devanneil/AutomaticAppleHarvesterCOBOT/QR.png

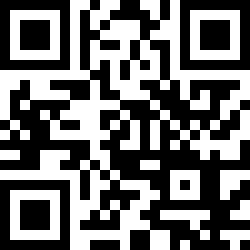
QR.png
