devanneil/AutomaticAppleHarvesterCOBOT/ws/src/robot_model/meshes/bin_assembly.stl

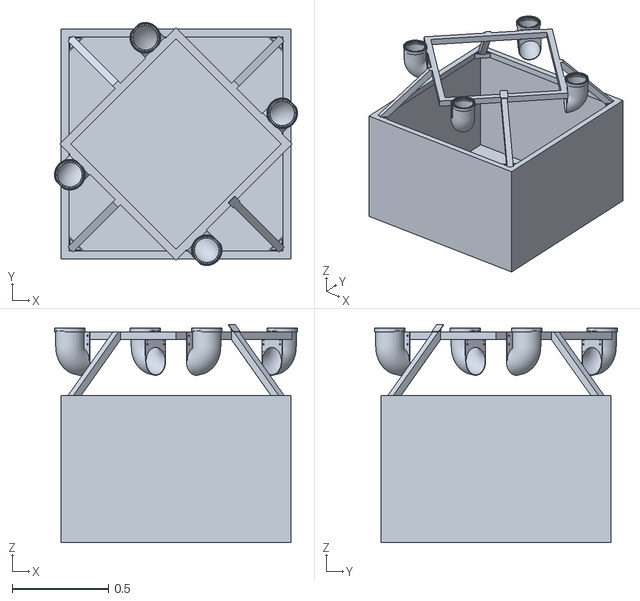
[picture p10: CAD file, 2026-06-25]
ws/src/robot_model/meshes/bin_assembly.stl
1.26 x 1.26 x 1.13
