devanneil/AutomaticAppleHarvesterCOBOT/ws/src/robot_model/meshes/bin_filler/Bottom_Frame_2.stl

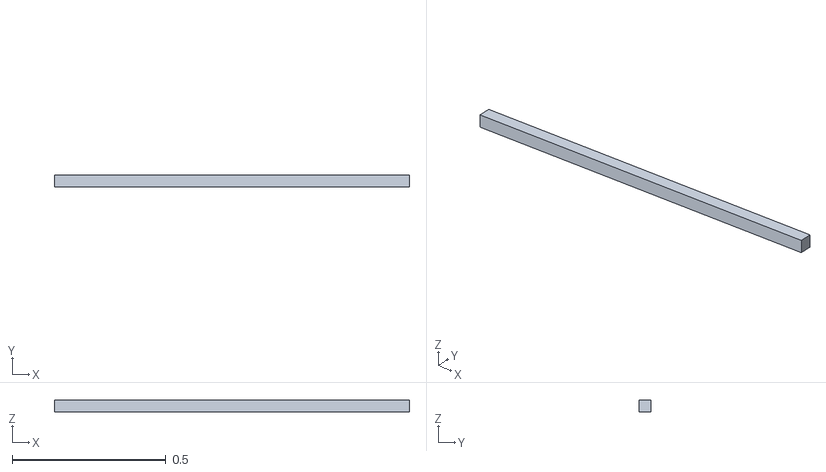
[picture p11: CAD file, 2026-06-24]
ws/src/robot_model/meshes/bin_filler/Bottom_Frame_2.stl
1.15 x 0.04 x 0.04
