devanneil/AutomaticAppleHarvesterCOBOT/ws/src/robot_model/meshes/bin_filler/Corner_8020_Series_15_Bracket_4222026_1.stl

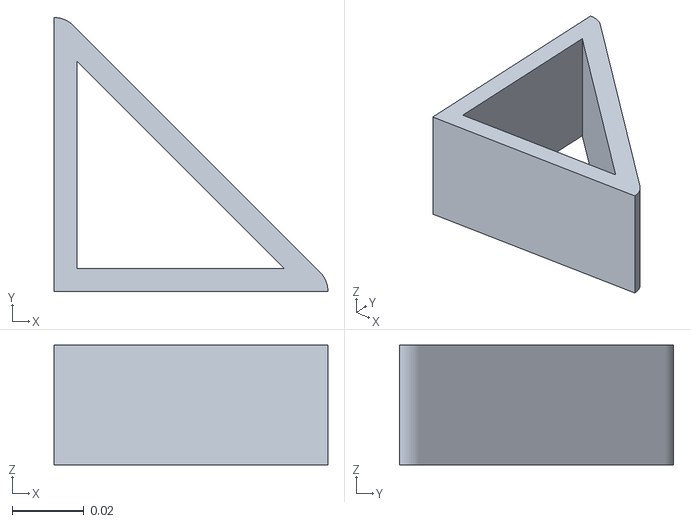
[picture p12: CAD file, 2026-06-24]
ws/src/robot_model/meshes/bin_filler/Corner_8020_Series_15_Bracket_4222026_1.stl
0.0762 x 0.0762 x 0.0333
