devanneil/AutomaticAppleHarvesterCOBOT/ws/src/robot_model/meshes/End_Effector_Bracket_4.2.2026.stl

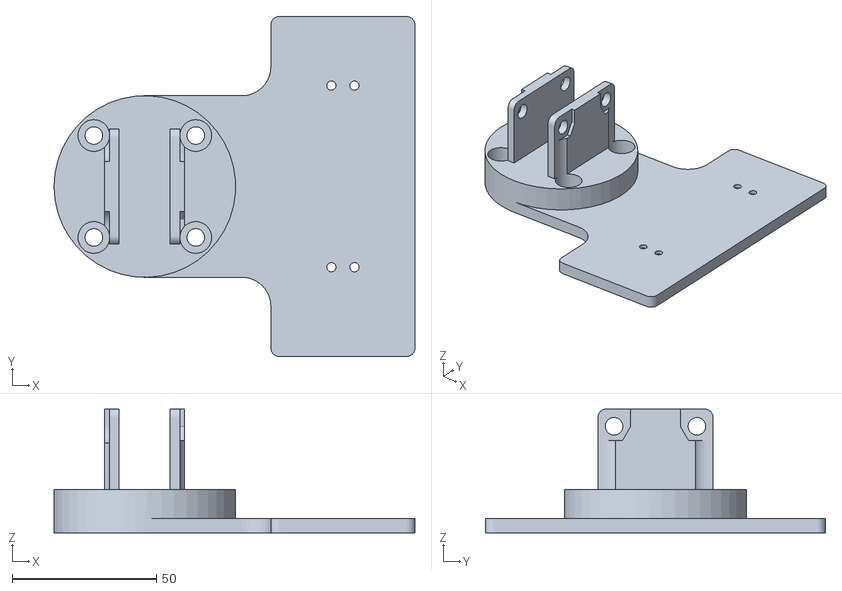
[picture p13: CAD file, 2026-05-20]
ws/src/robot_model/meshes/End_Effector_Bracket_4.2.2026.stl
125.2 x 118.0 x 43.0
