devanneil/AutomaticAppleHarvesterCOBOT/ws/src/robot_model/meshes/bin_filler/Angle_Bracket_1.stl

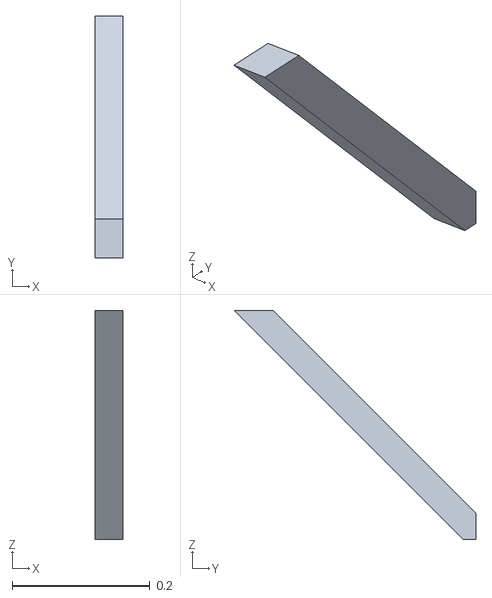
[picture p14: CAD file, 2026-06-24]
ws/src/robot_model/meshes/bin_filler/Angle_Bracket_1.stl
0.04 x 0.351 x 0.332
