devanneil/AutomaticAppleHarvesterCOBOT/ws/src/robot_model/meshes/DS87-Mechanical_Outline_3D.STP.stl

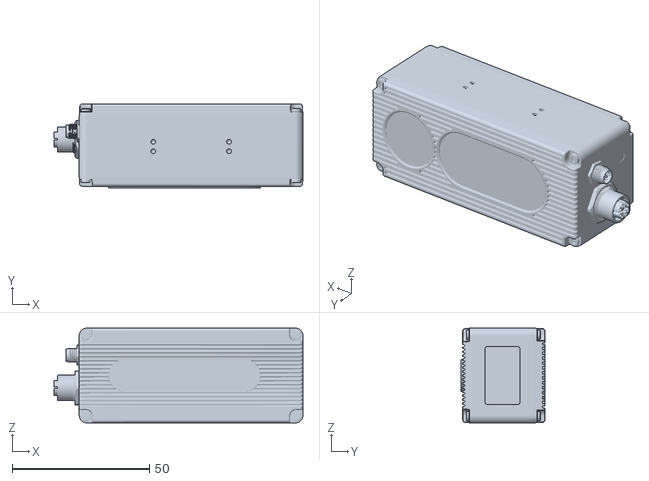
[picture p15: CAD file, 2026-04-21]
ws/src/robot_model/meshes/DS87-Mechanical_Outline_3D.STP.stl
90.8 x 30.8 x 34.6
