devanneil/AutomaticAppleHarvesterCOBOT/ws/src/robot_model/meshes/bin_filler/Apple_Chute_Entrance_4242026_1.stl

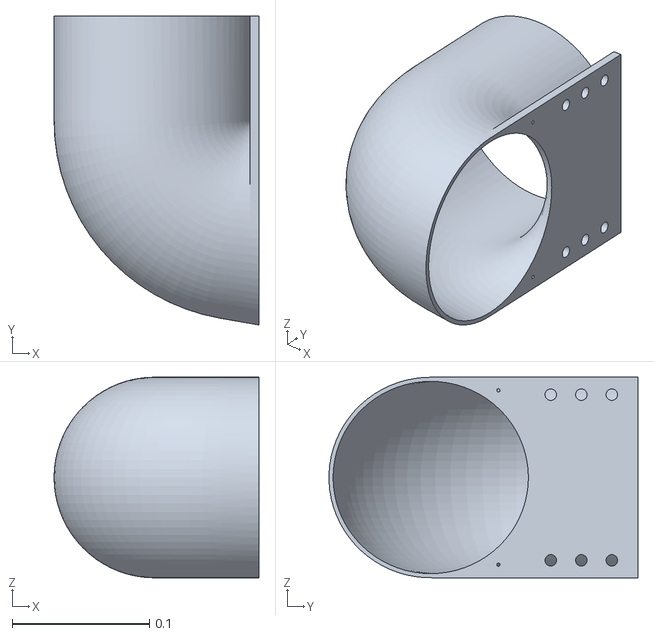
[picture p16: CAD file, 2026-06-24]
ws/src/robot_model/meshes/bin_filler/Apple_Chute_Entrance_4242026_1.stl
0.149 x 0.225 x 0.146
