devanneil/AutomaticAppleHarvesterCOBOT/ws/src/robot_model/meshes/bin_filler/Top_Frame_4.stl

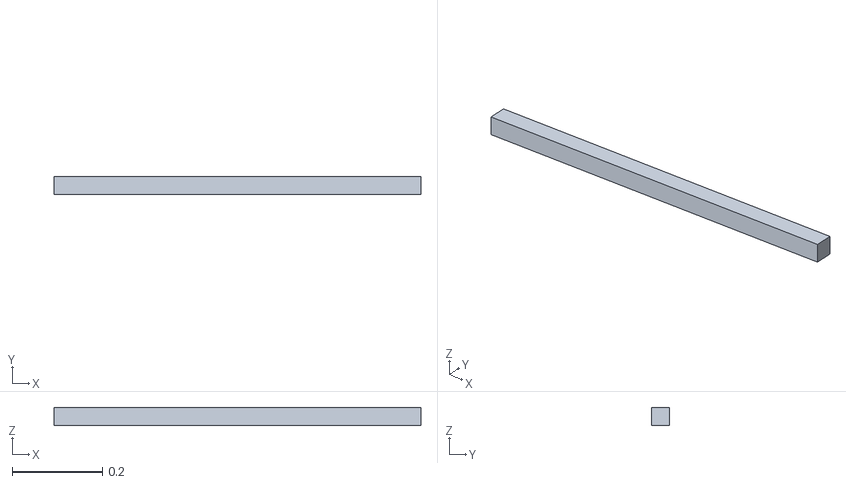
[picture p17: CAD file, 2026-06-24]
ws/src/robot_model/meshes/bin_filler/Top_Frame_4.stl
0.813 x 0.04 x 0.04
