devanneil/AutomaticAppleHarvesterCOBOT/ws/src/robot_model/meshes/bin_filler/Apple_Bin_4222026_1.stl

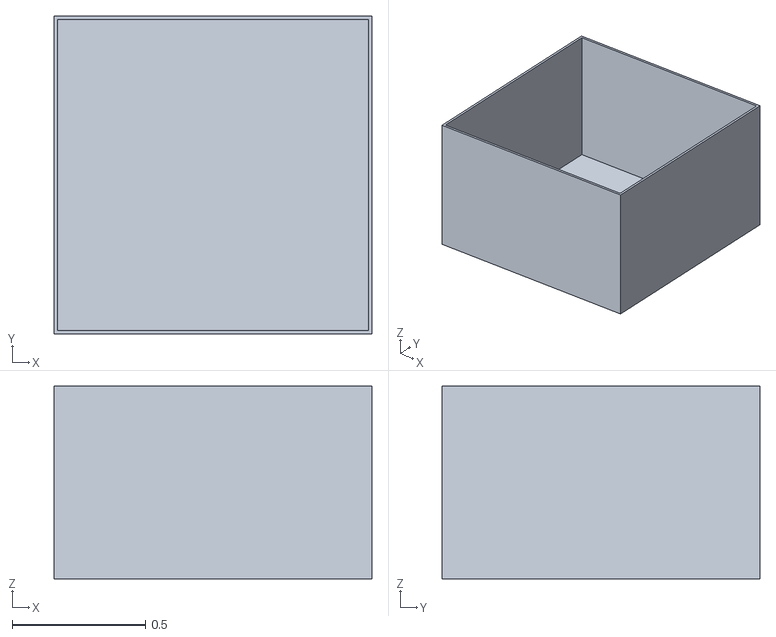
[picture p18: CAD file, 2026-06-24]
ws/src/robot_model/meshes/bin_filler/Apple_Bin_4222026_1.stl
1.19 x 1.19 x 0.724
