devanneil/AutomaticAppleHarvesterCOBOT/ws/src/robot_model/meshes/bin_filler/Rubber_Chute_Entrance_Bumper_54206_3.stl

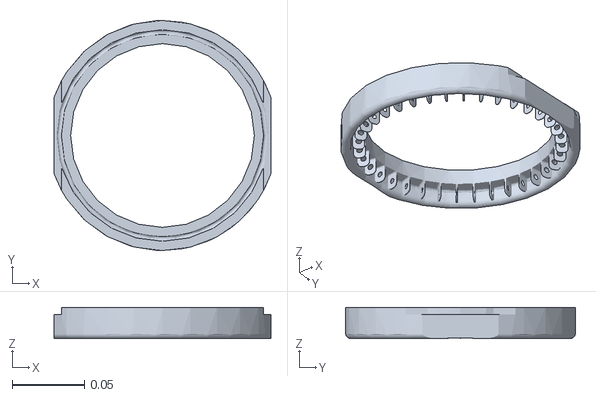
[picture p19: CAD file, 2026-06-24]
ws/src/robot_model/meshes/bin_filler/Rubber_Chute_Entrance_Bumper_54206_3.stl
0.15 x 0.159 x 0.0215
