devanneil/AutomaticAppleHarvesterCOBOT/ws/src/robot_model/meshes/bin_filler/8020-15_Angled_Short_End_Cap_w_QR_Flag_6152026_1.stl

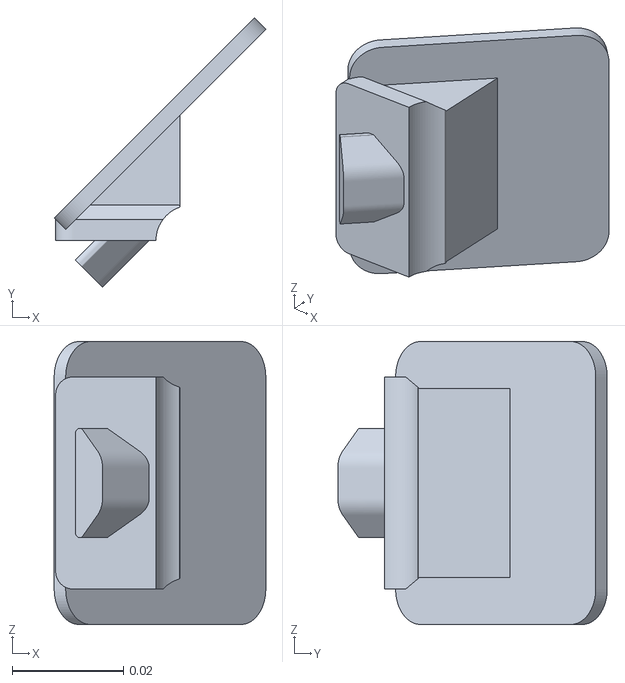
[picture p20: CAD file, 2026-06-24]
ws/src/robot_model/meshes/bin_filler/8020-15_Angled_Short_End_Cap_w_QR_Flag_6152026_1.stl
0.038 x 0.0484 x 0.0508
