devanneil/AutomaticAppleHarvesterCOBOT/ws/src/robot_model/meshes/bin_filler/Top_Frame_2.stl

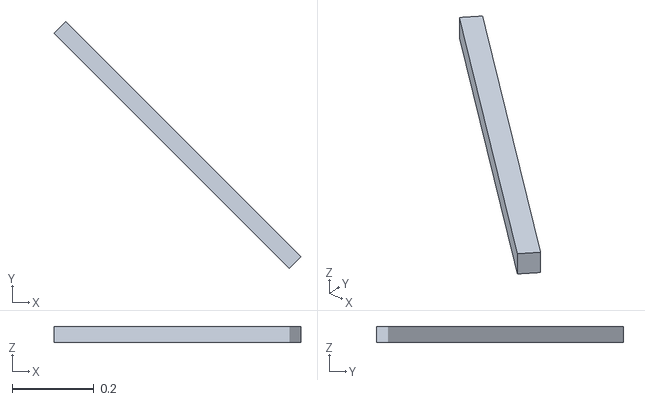
[picture p21: CAD file, 2026-06-24]
ws/src/robot_model/meshes/bin_filler/Top_Frame_2.stl
0.603 x 0.603 x 0.04
