devanneil/AutomaticAppleHarvesterCOBOT/ws/src/robot_model/meshes/bin_filler/Corner_8020_Series_15_Bracket_4222026_2.stl

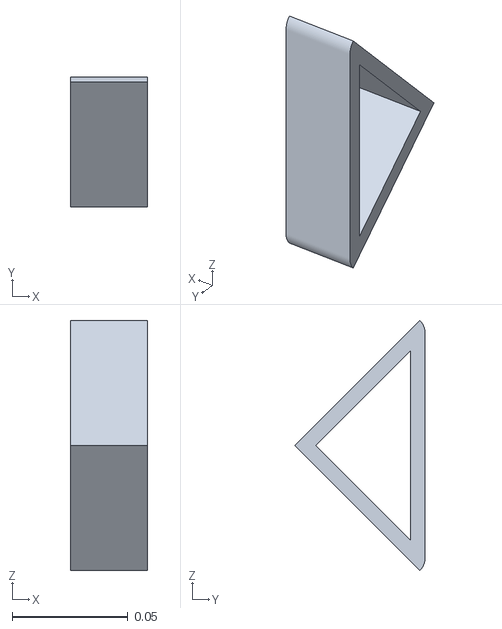
[picture p22: CAD file, 2026-06-24]
ws/src/robot_model/meshes/bin_filler/Corner_8020_Series_15_Bracket_4222026_2.stl
0.0333 x 0.0561 x 0.108
