devanneil/AutomaticAppleHarvesterCOBOT/ws/src/robot_model/meshes/bin_filler/QR_Code_1.stl

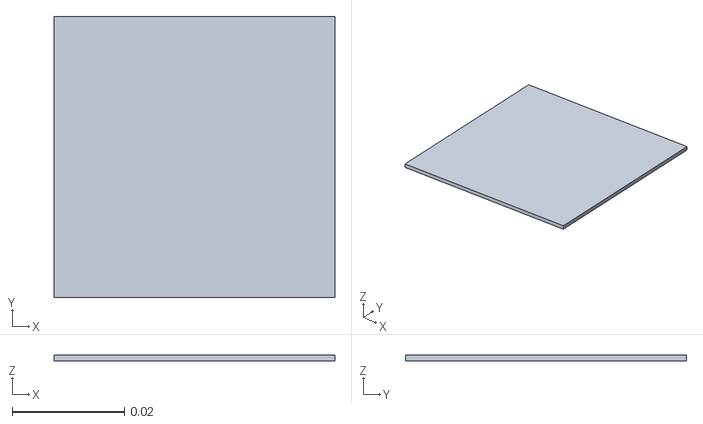
[picture p23: CAD file, 2026-06-24]
ws/src/robot_model/meshes/bin_filler/QR_Code_1.stl
0.05 x 0.05 x 0.001
