devanneil/AutomaticAppleHarvesterCOBOT/(list of files, cad)

Other CAD files:
ws/src/robot_model/meshes/bin_filler/Apple_Chute_Entrance_4242026_2.stl
ws/src/robot_model/meshes/bin_filler/Angle_Bracket_2.stl
ws/src/robot_model/meshes/bin_filler/Angle_Bracket_3.stl
ws/src/robot_model/meshes/bin_filler/Corner_8020_Series_15_Bracket_4222026_3.stl
ws/src/robot_model/meshes/bin_filler/Bottom_Frame_4.stl
ws/src/robot_model/meshes/bin_filler/Bottom_Frame_3.stl
ws/src/robot_model/meshes/bin_filler/Corner_8020_Series_15_Bracket_4222026_4.stl
ws/src/robot_model/meshes/bin_filler/Rubber_Chute_Entrance_Bumper_54206_2.stl
ws/src/robot_model/meshes/bin_filler/Angle_Bracket_4.stl
ws/src/robot_model/meshes/bin_filler/Apple_Chute_Entrance_4242026_4.stl
ws/src/robot_model/meshes/bin_filler/Bottom_Frame_1.stl
ws/src/robot_model/meshes/bin_filler/Rubber_Chute_Entrance_Bumper_54206_4.stl
ws/src/robot_model/meshes/bin_filler/Top_Frame_1.stl
ws/src/robot_model/meshes/bin_filler/Top_Frame_3.stl
ws/src/robot_model/meshes/bin_filler/Rubber_Chute_Entrance_Bumper_54206_1.stl
ws/src/robot_model/meshes/bin_filler/Apple_Chute_Entrance_4242026_3.stl
