devanneil/AutomaticAppleHarvesterCOBOT/ws/src/robot_model/urdf/gcr16_2000.urdf

<?xml version="1.0" ?>
<!-- =================================================================================== -->
<!-- |    This document was autogenerated by xacro from src/robot_moveit_config/config/gcr16_2000.urdf.xacro | -->
<!-- |    EDITING THIS FILE BY HAND IS NOT RECOMMENDED                                 | -->
<!-- =================================================================================== -->
<robot name="gcr16_2000">
  <link name="base_link">
    <inertial>
      <origin rpy="0 0 0" xyz="1.0276E-05 0.014119 0.064841"/>
      <mass value="0"/>
      <inertia ixx="0.0" ixy="0.0" ixz="0.0" iyy="0.0" iyz="0.0" izz="0.0"/>
    </inertial>
    <visual>
      <origin rpy="0 0 0" xyz="0 0 0"/>
      <geometry>
        <mesh filename="package://duco_support/meshes/GCR16_2000/base_link.stl"/>
      </geometry>
      <material name="">
        <color rgba="0.73333 0.78039 0.83922 1"/>
      </material>
    </visual>
    <collision>
      <origin rpy="0 0 0" xyz="0 0 0"/>
      <geometry>
        <mesh filename="package://duco_support/meshes/GCR16_2000/base_link.stl"/>
      </geometry>
    </collision>
  </link>
  <link name="link_1">
    <inertial>
      <origin rpy="0 0 0" xyz="0.000021 0.004967 -0.01790"/>
      <mass value="4.657"/>
      <inertia ixx="1.0752E-05" ixy="7.523E-09" ixz="1.0743E-08" iyy="1.0133197E-05" iyz="4.49349E-07" izz="7.870754E-05"/>
    </inertial>
    <visual>
      <origin rpy="0 0 0" xyz="0 0 0"/>
      <geometry>
        <mesh filename="package://duco_support/meshes/GCR16_2000/link_1.stl"/>
      </geometry>
      <material name="">
        <color rgba="0.79216 0.81961 0.93333 1"/>
      </material>
    </visual>
    <collision>
      <origin rpy="0 0 0" xyz="0 0 0"/>
      <geometry>
        <mesh filename="package://duco_support/meshes/GCR16_2000/link_1.stl"/>
      </geometry>
    </collision>
  </link>
  <joint name="arm_1_joint_1" type="revolute">
    <origin rpy="0 0 0" xyz="0 0 0.235"/>
    <parent link="base_link"/>
    <child link="link_1"/>
    <axis xyz="0 0 1"/>
    <limit effort="850" lower="-3.1415926535" upper="3.1415926535" velocity="2.094395102"/>
  </joint>
  <link name="link_2">
    <inertial>
      <origin rpy="0 0 0" xyz="1.102E-07 0.020908 0.00079543"/>
      <mass value="12.162"/>
      <inertia ixx="0.067005" ixy="3.4805E-07" ixz="2.7185E-07" iyy="0.067506" iyz="-0.0064954" izz="0.071423"/>
    </inertial>
    <visual>
      <origin rpy="0 0 0" xyz="0 0 0"/>
      <geometry>
        <mesh filename="package://duco_support/meshes/GCR16_2000/link_2.stl"/>
      </geometry>
      <material name="">
        <color rgba="0.79216 0.81961 0.93333 1"/>
      </material>
    </visual>
    <collision>
      <origin rpy="0 0 0" xyz="0 0 0"/>
      <geometry>
        <mesh filename="package://duco_support/meshes/GCR16_2000/link_2.stl"/>
      </geometry>
    </collision>
  </link>
  <joint name="arm_1_joint_2" type="revolute">
    <origin rpy="1.5708 -1.5708 3.1416" xyz="0 0.1608 0"/>
    <parent link="link_1"/>
    <child link="link_2"/>
    <axis xyz="0 0 1"/>
    <limit effort="850" lower="-3.1415926" upper="3.1415926" velocity="2.094395102"/>
  </joint>
  <link name="link_3">
    <inertial>
      <origin rpy="0 0 0" xyz="0.31434 -1.0432E-06 -0.11596"/>
      <mass value="6.787"/>
      <inertia ixx="0.029837" ixy="6.3415E-06" ixz="-0.00036881" iyy="0.71686" iyz="-4.683E-07" izz="0.71691"/>
    </inertial>
    <visual>
      <origin rpy="0 0 0" xyz="0 0 0"/>
      <geometry>
        <mesh filename="package://duco_support/meshes/GCR16_2000/link_3.stl"/>
      </geometry>
      <material name="">
        <color rgba="0.86667 0.86667 0.8902 1"/>
      </material>
    </visual>
    <collision>
      <origin rpy="0 0 0" xyz="0 0 0"/>
      <geometry>
        <mesh filename="package://duco_support/meshes/GCR16_2000/link_3.stl"/>
      </geometry>
    </collision>
  </link>
  <joint name="arm_1_joint_3" type="revolute">
    <origin rpy="0 0 0" xyz="0.9775 0 0"/>
    <parent link="link_2"/>
    <child link="link_3"/>
    <axis xyz="0 0 1"/>
    <limit effort="440" lower="-3.1415926" upper="3.1415926" velocity="3.1415926535"/>
  </joint>
  <link name="link_4">
    <inertial>
      <origin rpy="0 0 0" xyz="1.2372E-05 -0.014753 -0.0001724"/>
      <mass value="2.453"/>
      <inertia ixx="0.001367" ixy="-1.1419E-07" ixz="-2.6082E-08" iyy="0.00054941" iyz="-2.3461E-05" izz="0.0013257"/>
    </inertial>
    <visual>
      <origin rpy="0 0 0" xyz="0 0 0"/>
      <geometry>
        <mesh filename="package://duco_support/meshes/GCR16_2000/link_4.stl"/>
      </geometry>
      <material name="">
        <color rgba="0.86667 0.86667 0.8902 1"/>
      </material>
    </visual>
    <collision>
      <origin rpy="0 0 0" xyz="0 0 0"/>
      <geometry>
        <mesh filename="package://duco_support/meshes/GCR16_2000/link_4.stl"/>
      </geometry>
    </collision>
  </link>
  <joint name="arm_1_joint_4" type="revolute">
    <origin rpy="0 0 1.5708" xyz="0.8965 0 0"/>
    <parent link="link_3"/>
    <child link="link_4"/>
    <axis xyz="0 0 1"/>
    <limit effort="75" lower="-3.1415926" upper="3.1415926" velocity="3.926990817"/>
  </joint>
  <link name="link_5">
    <inertial>
      <origin rpy="0 0 0" xyz="-1.2211E-05 0.014754 -0.00017351"/>
      <mass value="2.453"/>
      <inertia ixx="0.001367" ixy="-1.1551E-07" ixz="2.5518E-08" iyy="0.00054941" iyz="2.3461E-05" izz="0.0013257"/>
    </inertial>
    <visual>
      <origin rpy="0 0 0" xyz="0 0 0"/>
      <geometry>
        <mesh filename="package://duco_support/meshes/GCR16_2000/link_5.stl"/>
      </geometry>
      <material name="">
        <color rgba="0.86667 0.86667 0.8902 1"/>
      </material>
    </visual>
    <collision>
      <origin rpy="0 0 0" xyz="0 0 0"/>
      <geometry>
        <mesh filename="package://duco_support/meshes/GCR16_2000/link_5.stl"/>
      </geometry>
    </collision>
  </link>
  <joint name="arm_1_joint_5" type="revolute">
    <origin rpy="1.5708 0 0" xyz="0 -0.126 0"/>
    <parent link="link_4"/>
    <child link="link_5"/>
    <axis xyz="0 0 1"/>
    <limit effort="75" lower="-3.1415926" upper="3.1415926" velocity="3.926990817"/>
  </joint>
  <link name="link_6">
    <inertial>
      <origin rpy="0 0 0" xyz="-5.2419E-07 0.00029705 -0.025541"/>
      <mass value="2.453"/>
      <inertia ixx="3.517E-05" ixy="7.061E-10" ixz="7.5214E-11" iyy="3.4071E-05" iyz="-5.7792E-08" izz="6.3885E-05"/>
    </inertial>
    <visual>
      <origin rpy="0 0 0" xyz="0 0 0"/>
      <geometry>
        <mesh filename="package://duco_support/meshes/GCR16_2000/link_6.stl"/>
      </geometry>
      <material name="">
        <color rgba="0 0 0 1"/>
      </material>
    </visual>
    <collision>
      <origin rpy="0 0 0" xyz="0 0 0"/>
      <geometry>
        <mesh filename="package://duco_support/meshes/GCR16_2000/link_6.stl"/>
      </geometry>
    </collision>
  </link>
  <joint name="arm_1_joint_6" type="revolute">
    <origin rpy="-1.5708 0 0" xyz="0 0.113 0"/>
    <parent link="link_5"/>
    <child link="link_6"/>
    <axis xyz="0 0 1"/>
    <limit effort="75" lower="-3.1415926" upper="3.1415926" velocity="3.926990817"/>
  </joint>
  <ros2_control name="FakeSystem" type="system">
    <hardware>
      <!-- By default, set up controllers for simulation. This won't work on real hardware -->
      <plugin>mock_components/GenericSystem</plugin>
    </hardware>
    <joint name="arm_1_joint_1">
      <command_interface name="position"/>
      <state_interface name="position">
        <param name="initial_value">0</param>
      </state_interface>
    </joint>
    <joint name="arm_1_joint_2">
      <command_interface name="position"/>
      <state_interface name="position">
        <param name="initial_value">0</param>
      </state_interface>
    </joint>
    <joint name="arm_1_joint_3">
      <command_interface name="position"/>
      <state_interface name="position">
        <param name="initial_value">0</param>
      </state_interface>
    </joint>
    <joint name="arm_1_joint_4">
      <command_interface name="position"/>
      <state_interface name="position">
        <param name="initial_value">0</param>
      </state_interface>
    </joint>
    <joint name="arm_1_joint_5">
      <command_interface name="position"/>
      <state_interface name="position">
        <param name="initial_value">0</param>
      </state_interface>
    </joint>
    <joint name="arm_1_joint_6">
      <command_interface name="position"/>
      <state_interface name="position">
        <param name="initial_value">0</param>
      </state_interface>
    </joint>
  </ros2_control>
  <!-- ===================================================== -->
  <!-- Bracket -->
  <!-- ===================================================== -->
  <link name="bracket_link">
    <!-- VISUAL -->
    <visual>
      <origin rpy="0 0 0" xyz="0 0 0"/>
      <geometry>
        <mesh filename="package://robot_model/meshes/End_Effector_Bracket_4.2.2026.stl" scale="0.001 0.001 0.001"/>
      </geometry>
      <material name="gray">
        <color rgba="0.7 0.7 0.7 1.0"/>
      </material>
    </visual>
    <!-- COLLISION -->
    <collision>
      <origin rpy="0 0 0" xyz="0.0508 0 0.1016"/>
      <geometry>
        <box size="0.1778 0.3048 0.2032"/>
      </geometry>
    </collision>
  </link>
  <!-- ===================================================== -->
  <!-- Camera -->
  <!-- ===================================================== -->
  <link name="camera_link">
    <!-- VISUAL -->
    <visual>
      <origin rpy="0 0 0" xyz="0 0 0"/>
      <geometry>
        <mesh filename="package://robot_model/meshes/DS87-Mechanical_Outline_3D.STP.stl" scale="0.002 0.002 0.002"/>
      </geometry>
      <material name="gray">
        <color rgba="0.3 0.3 0.3 1.0"/>
      </material>
    </visual>
    <!-- COLLISION -->
  </link>
  <!-- ===================================================== -->
  <!-- Suction Sphere -->
  <!-- ===================================================== -->
  <link name="suction_link">
    <!-- VISUAL -->
    <visual>
      <origin rpy="0 0 0" xyz="0 0 0"/>
      <geometry>
        <sphere radius="0.05"/>
      </geometry>
      <material name="green">
        <color rgba="0 1.0 0 0.5"/>
      </material>
    </visual>
    <!-- COLLISION -->
    <collision>
      <origin rpy="0 0 0" xyz="0 0 0"/>
      <geometry>
        <sphere radius="0.05"/>
      </geometry>
    </collision>
  </link>
  <!-- ===================================================== -->
  <!-- TOOL CENTER POINT (TCP) -->
  <!-- ===================================================== -->
  <link name="tool_frame"/>
  <!-- ===================================================== -->
  <!-- JOINTS -->
  <!-- ===================================================== -->
  <!-- Camera Mount -->
  <joint name="camera_joint" type="fixed">
    <parent link="bracket_link"/>
    <child link="camera_link"/>
    <origin rpy="1.57079633 0 1.57079633" xyz="0.0675 0 0.0254"/>
  </joint>
  <!-- Suction Mount -->
  <joint name="suction_joint" type="fixed">
    <parent link="bracket_link"/>
    <child link="suction_link"/>
    <origin rpy="0 0 0" xyz="0 0 0.2413"/>
  </joint>
  <!-- Tool Frame -->
  <joint name="tool_frame_joint" type="fixed">
    <parent link="suction_link"/>
    <child link="tool_frame"/>
    <!-- TCP location -->
    <origin rpy="0 -1.57079633 1.57079633" xyz="0 0 0.05"/>
  </joint>
  <joint name="tool_mount_joint" type="fixed">
    <parent link="link_6"/>
    <child link="bracket_link"/>
    <origin rpy="0 0 0" xyz="0 0 0"/>
  </joint>
</robot>
