devanneil/AutomaticAppleHarvesterCOBOT/ws/src/suction_commander/src/suction_commander.cpp

#include <memory>
#include <chrono>
#include <string>
#include <rclcpp/rclcpp.hpp>
#include <std_msgs/msg/u_int8.hpp>
#include <fcntl.h>
#include <termios.h>
#include <unistd.h>
#include <cstring>
#include "apple_interfaces/srv/suction_command.hpp"

std::string DEV = "/dev/ttyUSB0";

class SerialPort {
public:
    bool openPort(const std::string &device, int baud) {
        fd = open(device.c_str(), O_RDWR | O_NOCTTY | O_SYNC);

        if (fd < 0) {
            perror("Failed to open serial port");
            return false;
        }

        struct termios tty;
        memset(&tty, 0, sizeof tty);

        if (tcgetattr(fd, &tty) != 0) {
            perror("tcgetattr");
            return false;
        }

        cfsetispeed(&tty, B115200);
        cfsetospeed(&tty, B115200);

        tty.c_cflag = (tty.c_cflag & ~CSIZE) | CS8;
        tty.c_iflag &= ~IGNBRK;
        tty.c_lflag = 0;
        tty.c_oflag = 0;

        tty.c_cc[VMIN]  = 0;
        tty.c_cc[VTIME] = 1;   // faster polling

        tty.c_iflag &= ~(IXON | IXOFF | IXANY);
        tty.c_cflag |= (CLOCAL | CREAD);
        tty.c_cflag &= ~(PARENB | PARODD);
        tty.c_cflag &= ~CSTOPB;
        tty.c_cflag &= ~CRTSCTS;

        if (tcsetattr(fd, TCSANOW, &tty) != 0) {
            perror("tcsetattr");
            return false;
        }

        return true;
    }

    void writePacket(uint8_t header, uint8_t data) {
        std::lock_guard<std::mutex> lock(io_mutex);

        uint8_t packet[2] = {header, data};
        ::write(fd, packet, 2);
    }

    int readPacket(uint8_t &header, uint8_t &data) {
        std::lock_guard<std::mutex> lock(io_mutex);

        uint8_t buf[2];
        int n = ::read(fd, buf, 2);

        if (n == 2) {
            header = buf[0];
            data = buf[1];
        }

        return n;
    }

    int getFd() const { return fd; }

    ~SerialPort() {
        if (fd >= 0) close(fd);
    }

private:
    int fd = -1;
    std::mutex io_mutex;
};

class SuctionCommander : public rclcpp::Node
{
public:
    SuctionCommander() : Node("suction_commander")
    {
        while (rclcpp::ok())
        {
            if(serial.openPort("/dev/ttyUSB0", 115200))
            {
                break;
            }
            RCLCPP_WARN(get_logger(), "Unable to open serial port!");
            rclcpp::sleep_for(std::chrono::seconds(5));
        }

        _service = this->create_service<apple_interfaces::srv::SuctionCommand>(
            "suction_action",
            std::bind(&SuctionCommander::service_callback, this,
                std::placeholders::_1, std::placeholders::_2));

        state_pub = create_publisher<std_msgs::msg::UInt8>(
            "/suction_state", 10);

        reader_thread = std::thread(&SuctionCommander::readLoop, this);
        RCLCPP_INFO(get_logger(), "Suction commander successfuly initialized!");
    }
    ~SuctionCommander() {
        serial.writePacket(0xAA, 0);
    }
private:

    void service_callback(
        const std::shared_ptr<apple_interfaces::srv::SuctionCommand::Request> request,
        std::shared_ptr<apple_interfaces::srv::SuctionCommand::Response> response)
    {
        if (!request) {
            RCLCPP_ERROR(this->get_logger(), "Null request");
            response->success = false;
            return;
        }

        RCLCPP_INFO(this->get_logger(),
                    "Relay request: %d", request->relay_id);
        
        if(request->state) {
            // Enable Relay
            relayMask |= (1 << request->relay_id);
        } else {
            relayMask &= ~(1 << request->relay_id);
        }


        // ---- SEND PACKET ----
        serial.writePacket(0xAA, relayMask);

        RCLCPP_INFO(this->get_logger(),
                    "Sent mask: 0x%02X", relayMask);

        response->success = true;
    }

    void readLoop()
    {
        while (rclcpp::ok()) {

            uint8_t header = 0;
            uint8_t state = 0;

            if (::read(serial.getFd(), &header, 1) <= 0)
                continue;

            if (header != 0xAA)
                continue;

            if (::read(serial.getFd(), &state, 1) <= 0)
                continue;

            auto msg = std_msgs::msg::UInt8();
            msg.data = state;
            state_pub->publish(msg);
            // RCLCPP_INFO_THROTTLE(
            //     this->get_logger(),
            //     *this->get_clock(),
            //     1000, // milliseconds
            //     "Throttled message: '%u'", state
            // );
        }
    }

    SerialPort serial;

    rclcpp::Service<apple_interfaces::srv::SuctionCommand>::SharedPtr _service;
    rclcpp::Publisher<std_msgs::msg::UInt8>::SharedPtr state_pub;

    std::thread reader_thread;

    uint8_t relayMask = 0;
};

int main(int argc, char * argv[])
{
    rclcpp::init(argc, argv);

    auto node =
        std::make_shared<SuctionCommander>();

    rclcpp::spin(node);

    rclcpp::shutdown();

    return 0;
}
