devanneil/AutomaticAppleHarvesterCOBOT/ws/src/robot_moveit_config/config/joint_limits.yaml

# joint_limits.yaml allows the dynamics properties specified in the URDF to be overwritten or augmented as needed

# For beginners, we downscale velocity and acceleration limits.
# You can always specify higher scaling factors (<= 1.0) in your motion requests.  # Increase the values below to 1.0 to always move at maximum speed.
default_velocity_scaling_factor: 0.01
default_acceleration_scaling_factor: 0.1

# Specific joint properties can be changed with the keys [max_position, min_position, max_velocity, max_acceleration]
# Joint limits can be turned off with [has_velocity_limits, has_acceleration_limits]
joint_limits:
  arm_1_joint_1:
    has_position_limits: true
    has_velocity_limits: true
    max_velocity: 2.05948852
    has_acceleration_limits: false
    max_acceleration: 0
    min_position: -4.71238898
    max_position: 0.95993109
  arm_1_joint_2:
    has_position_limits: true
    has_velocity_limits: true
    max_velocity: 2.05948852
    has_acceleration_limits: false
    max_acceleration: 0
    min_position: -0.495
    max_position: 0.95993109
  arm_1_joint_3:
    has_position_limits: true
    has_velocity_limits: true
    max_velocity: 3.10668607
    has_acceleration_limits: false
    max_acceleration: 0
    min_position: -6.28318531
    max_position: 6.28318531
  arm_1_joint_4:
    has_position_limits: true
    has_velocity_limits: true
    max_velocity: 3.89208423
    has_acceleration_limits: false
    max_acceleration: 0
    min_position: -1.57079633
    max_position: 2.18166157
  arm_1_joint_5:
    has_position_limits: true
    has_velocity_limits: true
    max_velocity: 3.89208423
    has_acceleration_limits: false
    max_acceleration: 0
    min_position: -0.785398164
    max_position: 2.35619449
  arm_1_joint_6:
    has_position_limits: true
    has_velocity_limits: true
    max_velocity: 3.89208423
    has_acceleration_limits: false
    max_acceleration: 0
    min_position: -4.71238898
    max_position: 4.71238898
