devanneil/AutomaticAppleHarvesterCOBOT/(commit log)

2026-03-09 Currently attempting to setup a seperate container where I can put the DUCO drivers and the ros2 control code. This will allow us to build our own workspace without attempting to rebuild drivers ever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
2026-03-23 DUCO Sdk is compiling inside the docker container, need to test on actual hardware. Waiting to test camera on update infrastructure for tomorrow
2026-04-12 Updated launch config to handle launching from ws, need to recreate moveit config when I have box dimensions to avoid collision.
    [gcr16_2000.ros2_control.xacro, gcr16_2000.urdf.xacro, joint_limits.yaml, ros2_controllers.yaml]
2026-04-16 Added moveit config, integrated moveit config with arm launch infrastructure, added bin collision, tested arm and camera infrastructure. All set for visualization tomorrow
    [gcr16_2000.ros2_control.xacro, gcr16_2000.urdf.xacro, joint_limits.yaml, ros2_controllers.yaml]
2026-04-21 Committing before changes, include camera model and working launch_cam
    [DS87-Mechanical_Outline_3D.STP.stl]
2026-04-28 Added camera drive control node
2026-05-05 Update camera driver ot work independent of camera callback
2026-05-20 Removed camera drive function, removed single launch file, added end effector xacro and integrated with existing robot xacro
    [End_Effector_Bracket_4.2.2026.stl, end_effector.xacro, gcr16_2000.urdf.xacro, joint_limits.yaml]
2026-05-27 Updated camera to latest version of driver, and added click detection suport to camera_drive node. Not currently functioning.
    [gcr16_2000.ros2_control.xacro, gcr16_2000.urdf.xacro, joint_limits.yaml, ros2_controllers.yaml]
2026-05-29 Implemented TF listener and transform for camera raycast to depth frame
2026-06-03 Added moveit integration to cam_drive_control, need to update joint limits to enforce appropriate behaviour
2026-06-08 Seperated arm driver to it's own Node.
    [joint_limits.yaml]
2026-06-08 Moved arm interface to seperate c++ file, and updated moveit config to attempt to repair TF issue.
    [end_effector.xacro, gcr16_2000.urdf.xacro]
2026-06-10 Added automated attach script for esp32
2026-06-11 updated attach script
2026-06-15 Working on arm, not working version
    [suction_commander.cpp]
2026-06-16 Removed camera from cam_drive_control and to it's own node. Seeing significant speed increases. Need to verify data output.
2026-06-19 Updated moveit configs, don't try to edit with moveit_setup_assistant, it will override changes.
    [gcr16_2000.urdf, gcr16_2000.urdf.xacro]
2026-06-19 Repaired moveit config, only thing that requires manual editing is joint_limits
    [DS87-Mechanical_Outline_3D.STP.stl, End_Effector_Bracket_4.2.2026.stl, gcr16_2000.urdf, gcr16_2000.urdf.xacro, joint_limits.yaml]
2026-06-23 Finally found the problem, was casting data poorly. Arm moves to apples appropriately, needs correction for spatial bias.
2026-06-23 Repaired point_cloud_processor, we can now see apples and move to picking position.
    [joint_limits.yaml]
2026-06-23 Working arm controller with framework pick sequence. Next commit to include arduino sketch for esp32.
    [joint_limits.yaml]
2026-06-24 updated suction_commander to interface with esp32
2026-06-24 Added URDF for the bin filler, use QR_Code_1 for referencing the QR code's location
    [8020-15_Angled_Short_End_Cap_w_QR_Flag_6152026_1.stl, Angle_Bracket_1.stl, Angle_Bracket_2.stl, Angle_Bracket_3.stl, Angle_Bracket_4.stl, Apple_Bin_4222026_1.stl, Apple_Chute_Entrance_4242026_1.stl, Apple_Chute_Entrance_4242026_2.stl]
2026-06-25 Added dynamic bin support, with control over joints
    [bin_assembly.stl, bin_filler.urdf]
2026-06-25 Added qr code pose
    [bin_filler.urdf]
2026-06-26 Updated robot model for new dimensions and configured qr_monitor correctly
    [gcr16_2000.urdf]
2026-06-26 Added esp32 relay checking support
2026-06-27 Finally got bin scanner working, needed to reconfigure TF tree. It's all good now :)
    [bin_filler.urdf]
2026-07-02 Pick behavior reimplemented for arm state machine.
2026-07-03 Updates to arm controller, vacuum controller, and state machine to integrate suction with arm.
2026-07-03 Updated joint limits
    [joint_limits.yaml]
2026-07-03 Implemented twist pick. Made changes to increase comile efficiency and added additional error handling to move command.
    [main.cpp, state_machine.cpp, utils.cpp]
2026-07-03 Updated joint limits for moving to qr scan
    [joint_limits.yaml]
2026-07-03 Updated bin scanner to use service control, investigate mergin bin scanner to camera driver and use YOLO model.
2026-07-06 Created new camera drive node to use action interface instead of publish inteface
2026-07-06 Integrated qr scanning to the camera driver, this is the new and correct camera driver
2026-07-07 Integrated vision scan to arm controller
2026-07-07 Fixed bug with pick returning an invalid comman. Working on move_group error state handling. We cannot call a move directly after stop().
    [state_machine.cpp, utils.cpp]
2026-07-07 Updated joint limits to match controller velocity, currently running on safe mode. Update for normal mode in future.
    [joint_limits.yaml]
2026-07-10 Replaced point_cloud_processor to sync frames
    [state_machine.cpp, utils.cpp]
2026-07-10 Bug fixes and working bin scanner
    [state_machine.cpp, utils.cpp]
2026-07-24 Updated bin filler to be simpler URDF
    [bin_filler.urdf, bin_filler_deprecated.urdf]
2026-07-24 Added error handling to arm controller that actually works, needed to add respawn behavior to the DucoDriver from launch_vis/launch_single_arm.
    [state_machine.cpp, utils.cpp]
2026-07-24 Succeeded full wall test, added additional chute prepare state and integrated with hold state if arm fails with apple in grasp.
    [state_machine.cpp]
2026-07-24 Added system tests to /tests inside arm control package. Each test tests a single subsystem, but some tests are interdependent. QR scan and vision scan not implemented yet.
2026-07-27 Repaired some runtime bugs, vision scan timeout was not working, vision scan was reentrant, final pose results were skewed left
    [state_machine.cpp, utils.cpp]
2026-07-27 Investigated increasing velocity
    [joint_limits.yaml]
2026-07-28 Fixed monitor pose and added QR content checking and support for scan radius. Scan radius not implemented.
    [utils.cpp]
2026-07-29 Updated arm and camera for consistency and bug fixes
    [state_machine.cpp, test_vision_scan.cpp]
2026-07-29 Initial commit for scout_camera_scanner
    [bin_filler.urdf]
2026-07-29 Scout camera can now make and move several poses, investigate clustering algorithms for corners. Aiming for total coverage
2026-07-30 Added robot_workspace URDF. Will publish in launch_single_robot
    [robot_workspace.urdf]
2026-08-03 Created poses for scout camera, need to implement service to get next pose for arm
2026-08-05 Adding pick and place pipeline test along with compatibility and bugfixes. Begin work on scan pose system
    [bin_filler.urdf, gcr16_2000.urdf, joint_limits.yaml, robot_workspace.urdf]
2026-08-07 Finally may have solved planning. Added workspace constraint and applied RTTStar planning.
    [joint_limits.yaml]
2026-08-20 Small tweaks to infrastructure, changed camera model to handle light diffusion better.
2026-08-20 Test single threaded movement and small tweaks
2026-08-20 Test single threaded results and small tweaks
2026-08-20 So camera driver was broken.
2026-08-24 Output poses from camera are now ordered by x coordinate, and camera driver logs the time to complete.
2026-08-24 Updated the executable structure to close WSL, to reliably open the USB device, and to save the ROS logs of each run. We CANNOT leave it like this for long, as I am not sure if ROS logs are persisten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
2026-08-25 Increase chute wait time and decouple hold from heatscan behaviour. Heatscan is getting moved to it's own script.
2026-08-25 Fixed breaking change, qr scan and pick/place work again
    [state_machine.cpp]
2026-08-25 Updates and small bugfixes as well as diagrams for README
    [test_pick_place.cpp]
2026-09-10 Documentation and last minute fixes
    [esp_32_suction_control.ino, state_machine.cpp]
2026-09-11 Hard coded QR position for Demo
    [joint_limits.yaml]
2026-09-12 Restored chute approach and fixed retreat loop bug
    [state_machine.cpp]
2026-09-12 Lots of changes for field testing, update APPLE_FAR_LIMIT in cam drive control for demo
    [joint_limits.yaml]
2026-09-15 More tweaks before demo
    [joint_limits.yaml]
